nseidle/Bernoulli_Blower_Controller/images/Closeup-Controller.jpg

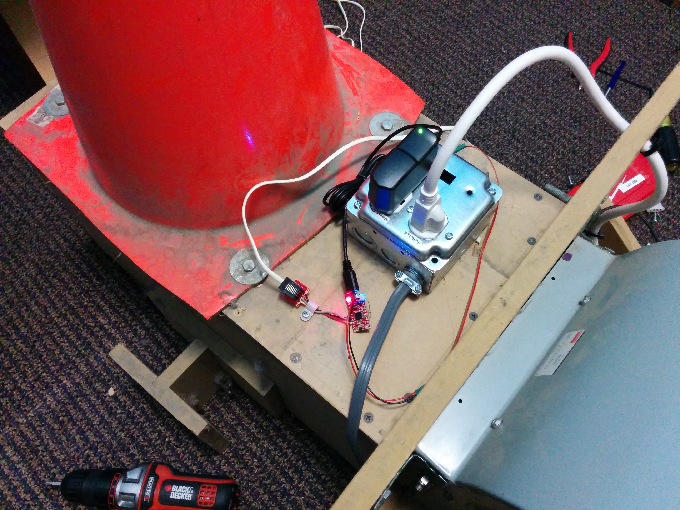
images/Closeup-Controller.jpg
