nseidle/Bernoulli_Blower_Controller/images/Overall-System-2.jpg

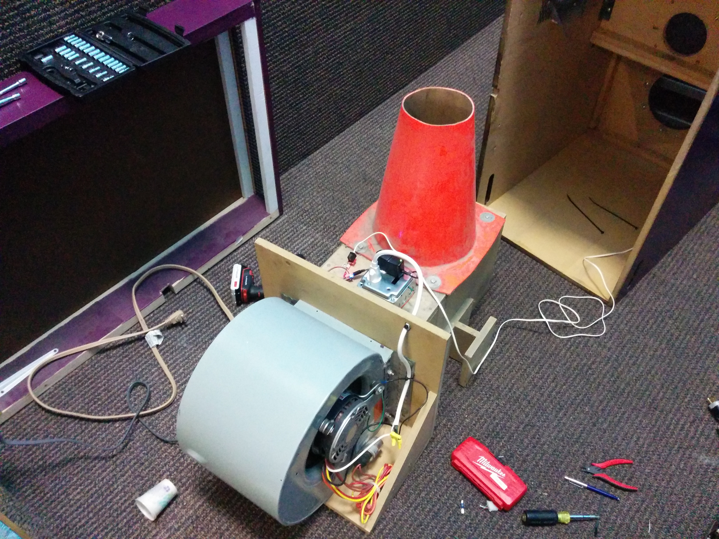
images/Overall-System-2.jpg
